Mehmet-Emre-Dogan/EE464_2022-2023_TermProject/README.md

# EE464_2022-2023_TermProject
 Hardware Project for EE464

 https://github.com/odtu/ee464

# Magnetic Design Report
 https://github.com/Mehmet-Emre-Dogan/EE464_2023_HW2_Team08
 
 # Experiments
 
 ## 0th Experiment
 https://youtu.be/MJ3PV6YCNdQ
