Mehmet-Emre-Dogan/EE464_2022-2023_TermProject/presentation/presentation.pptx

## EE464 Static Power Conversion II Hardware Project Feedback Presentation

Mehmet Emre Doğan
Metehan Küçükler

## Outline

- Problem Definition
- Topology Selection
- Plan B
- Targeted Bonuses
- Experimental Results
- Simulation Result
- Component Selection
- Conclusion

## Problem Definition

→ Isolated DC-DC converter with specs:
- Minimum Input Voltage: 12 V
- Maximum Input Voltage: 18 V
- Output Voltage: 48 V
- Output Power: 48 W
- Output Voltage P2P Ripple: 3%
- Line Regulation: 3%
- Load Regulation: 3%

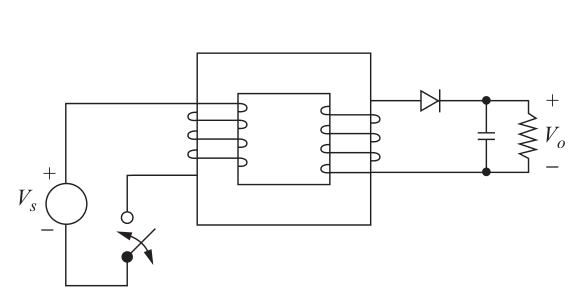
[picture p27: figure]

## Topology Selection

- Available topologies:
- Flyback converter
- Forward converter
- Push-Pull converter

## Topology Selection

- Flyback topology is chosen
- Requires less turns ratio compared to forward converter
- Requires more basic transformer compared to push-pull converter
- Require less number of components
- More importantly, we have found controller IC UCC2813DTR-1*
- The IC has a base design on TI Webench

* https://www.ti.com/product/UCC2813%2D1

## Topology Selection

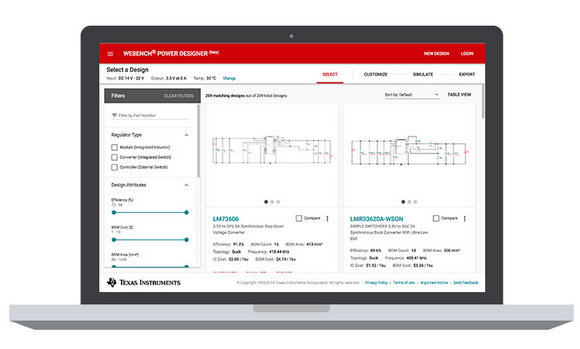
[picture p28: figure]

- TI Webench
- Online tool to make power electronics circuit designs

https://webench.ti.com/power-designer/switching-regulator

## Slide 7

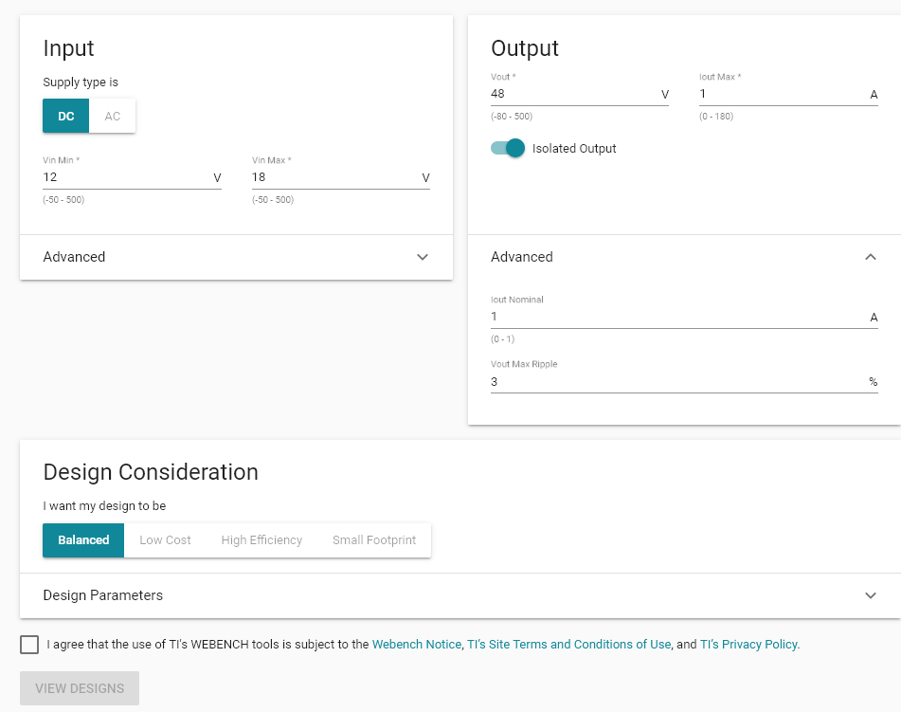
[picture p29: figure]

## In Case Analog IC Cause Unsolvable Problems

- Arduino (ESP8266) based solution
- ROE series isolated converters
- I2C ADC ADS1115
- I2C Isolator ISO1642DWR
- ESP in primary
- Isolated ADC in secondary

## Targeted Bonuses

- Single Supply
- Current Mode Control
- Analog Controller IC
- PCB
- Industrial Design
- Efficiency: Depends on other teams

## Experimental Results

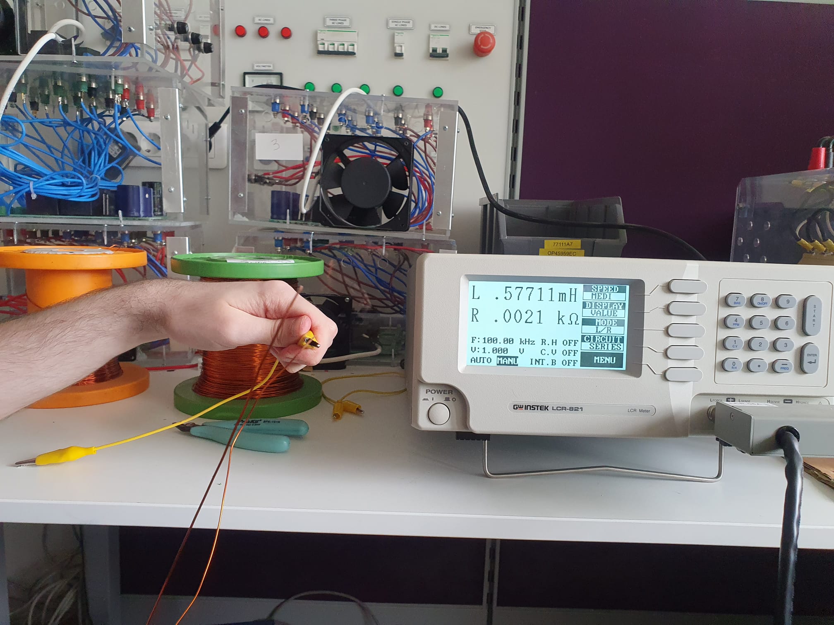
[picture p30: figure]
makine, metin, iç mekan, elektronik donanım içeren bir resim Açıklama otomatik olarak oluşturuldu

## Experimental Results

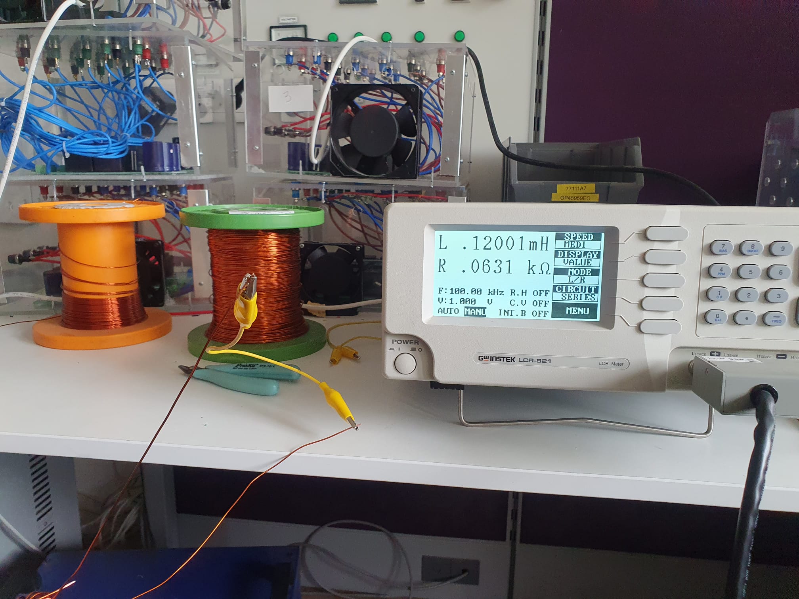
[picture p31: figure]
metin, makine, iç mekan, tıbbi cihazlar içeren bir resim Açıklama otomatik olarak oluşturuldu

## Experimental Results

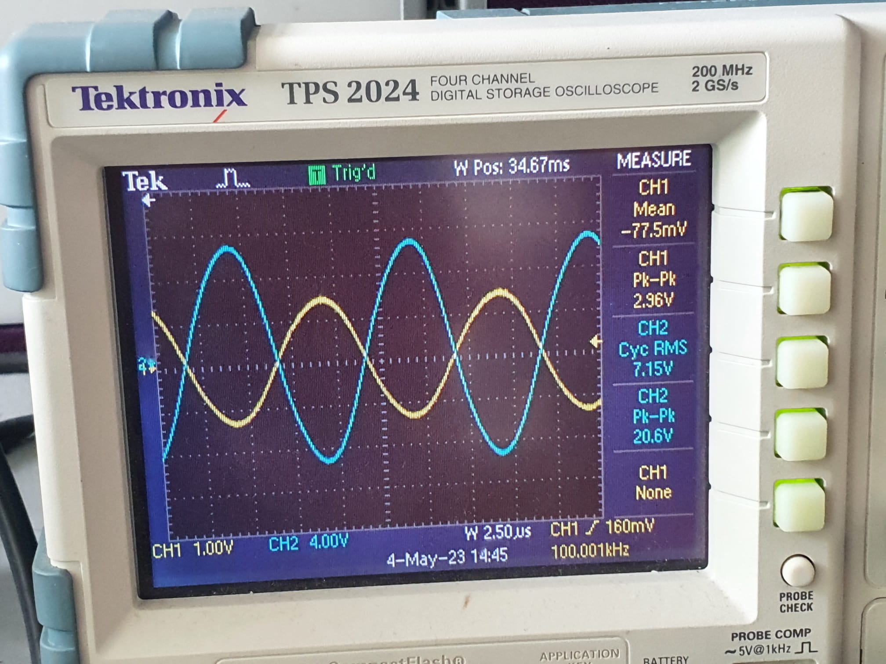
[picture p32: figure]
metin, elektronik donanım, multimedya, ekran içeren bir resim Açıklama otomatik olarak oluşturuldu

## Experimental Results

## Simulation Results

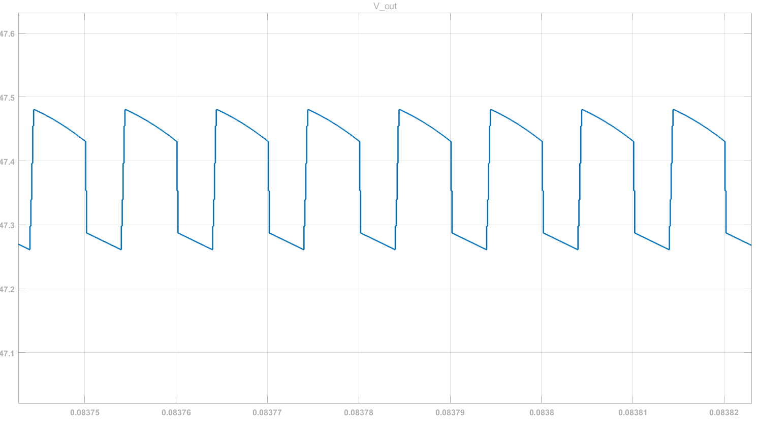
[picture p33: figure]
metin, yazı tipi, ekran görüntüsü, diyagram içeren bir resim Açıklama otomatik olarak oluşturuldu

## Simulation Results

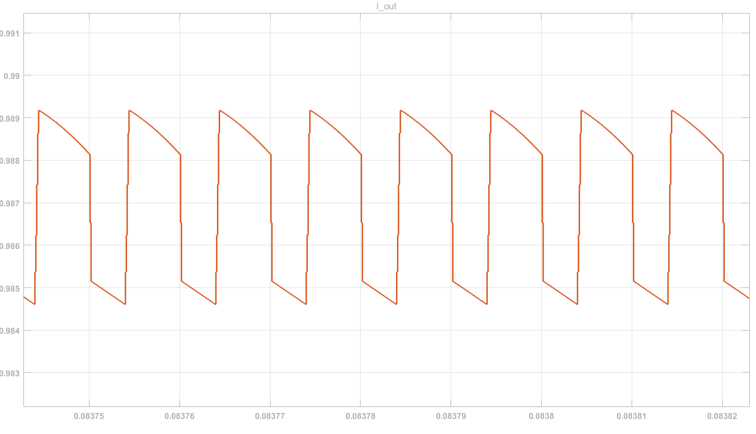
[picture p34: figure]
çizgi, öykü gelişim çizgisi; kumpas; grafiğini çıkarma, diyagram, paralel içeren bir resim Açıklama otomatik olarak oluşturuldu

## Simulation Results

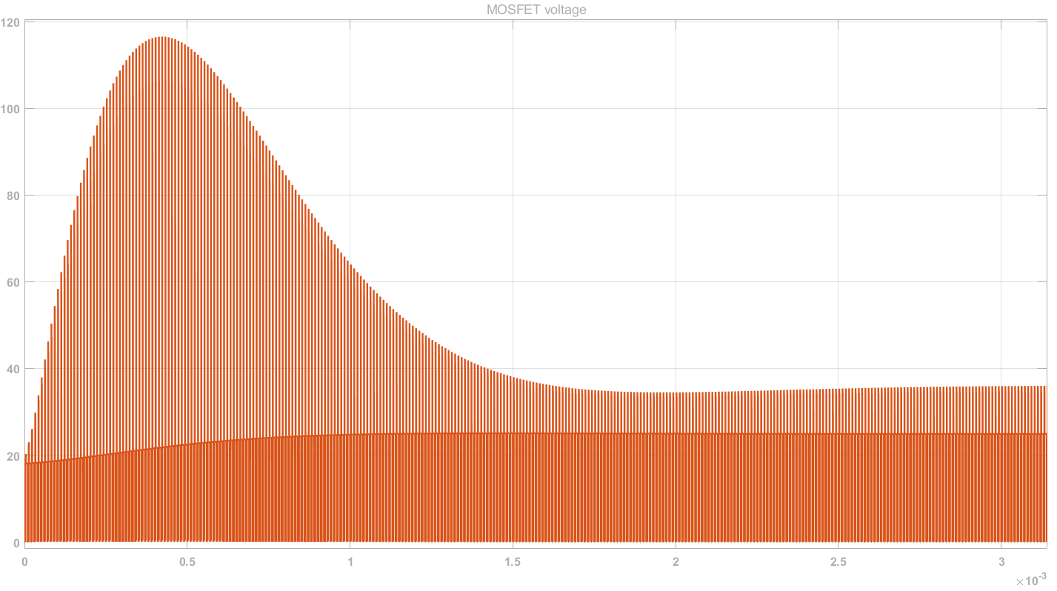
[picture p35: figure]

## Simulation Results

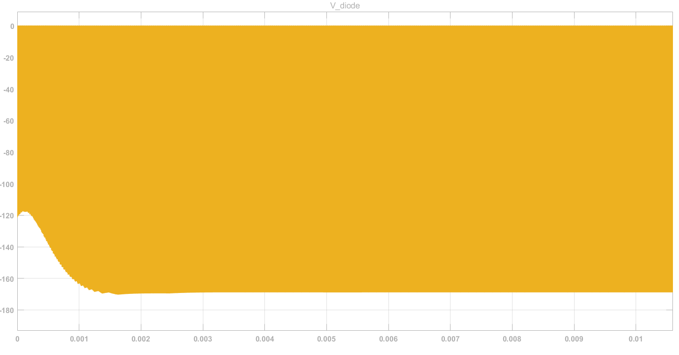
[picture p36: figure]

## Simulation Results

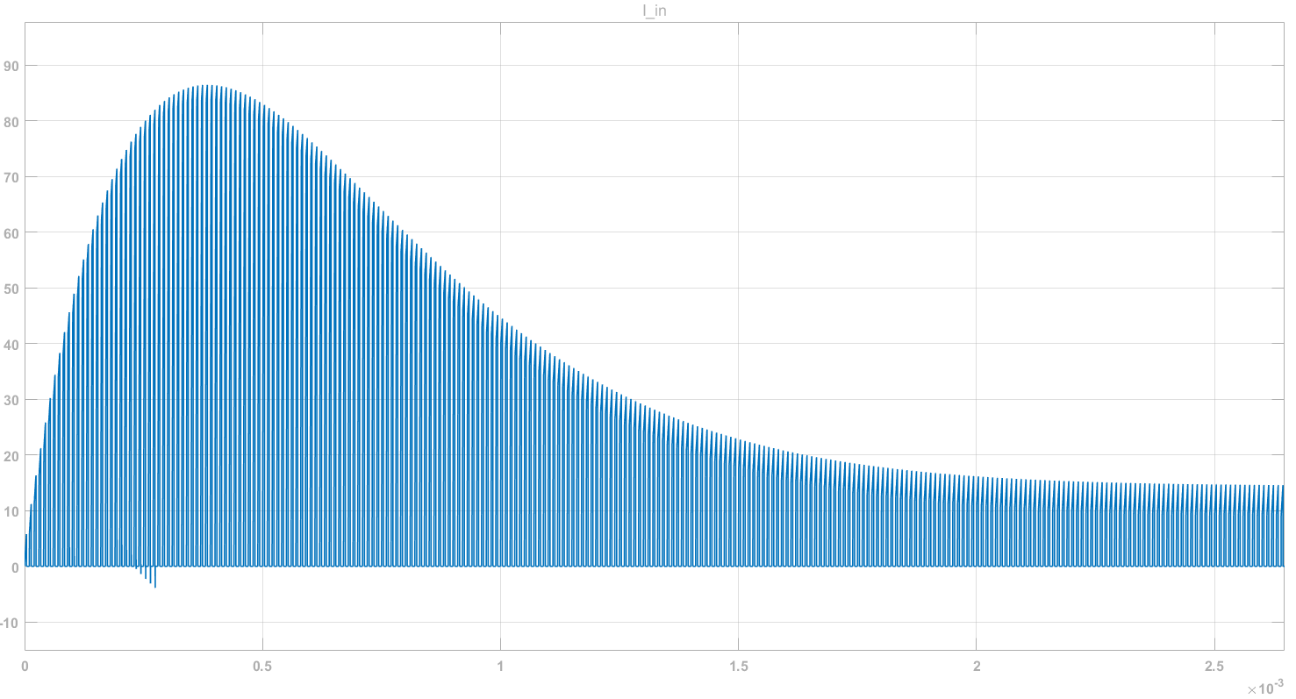
[picture p37: figure]
çizgi, öykü gelişim çizgisi; kumpas; grafiğini çıkarma, ekran görüntüsü, eğim, bayır içeren bir resim Açıklama otomatik olarak oluşturuldu

## Component Selection

MOSFET -> CSD19502Q5B
Vds = 80V, Ids = 100A, Rds = 3.8mΩ

DIODE -> SE10DTLJ
Vrrm = 600V, If = 10 A, Vf = 0.83 V

Output Capacitor
C = 47μF, V_rated = 100 V, ESR = 330mΩ

## Conclusion

- First implementations on perforated prototype board
- Continue improving transformer design to reduce leakage inductance
- Test and calibrate feedback and compensation of the controller IC
