Mehmet-Emre-Dogan/EE464_2022-2023_TermProject/case.stl

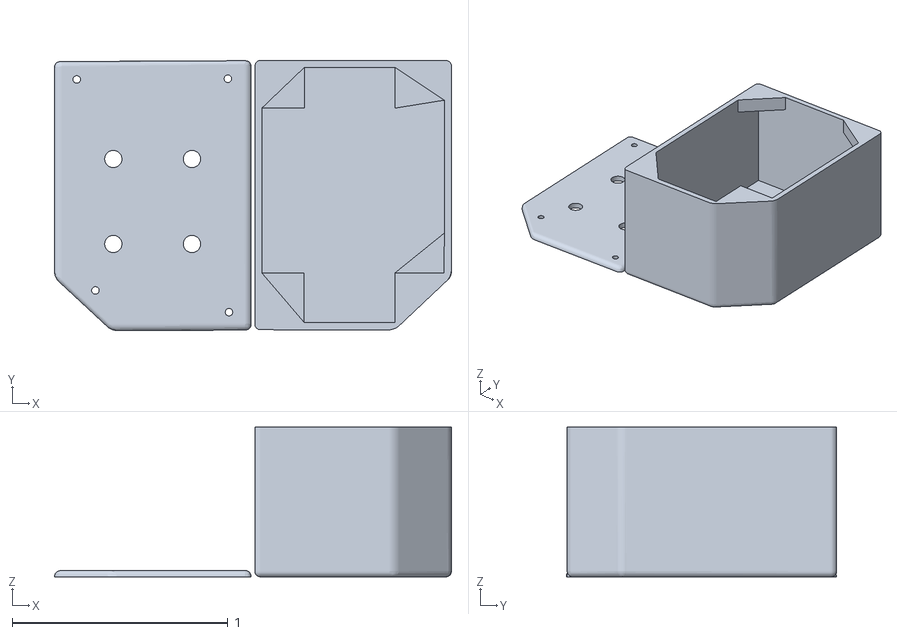
[picture p63: CAD file, 2023-06-14]
case.stl
1.84 x 1.25 x 0.694
