Mehmet-Emre-Dogan/EE464_2022-2023_TermProject/transformer v1.step

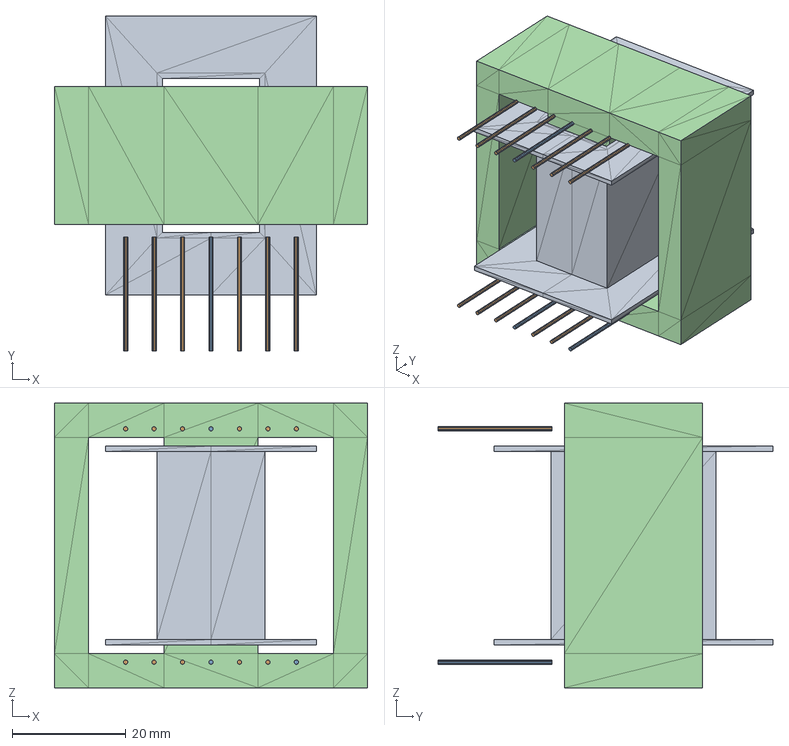
[picture p64: CAD file, 2023-06-14]
transformer v1.step
55.0 x 58.8 x 50.0 mm
