Mehmet-Emre-Dogan/EE464_2022-2023_TermProject/(list of files, cad)

Other CAD files:
transformer.step
transformer v1.stl
transformer.stl
