Mehmet-Emre-Dogan/EE464_2022-2023_TermProject/experiments/transformer_winding/readme.md

# First Transformer Experiment
The wounded toroidal transformer is tested with 100 kHz sinusoidal waveform with a signal generator.

## Transformer
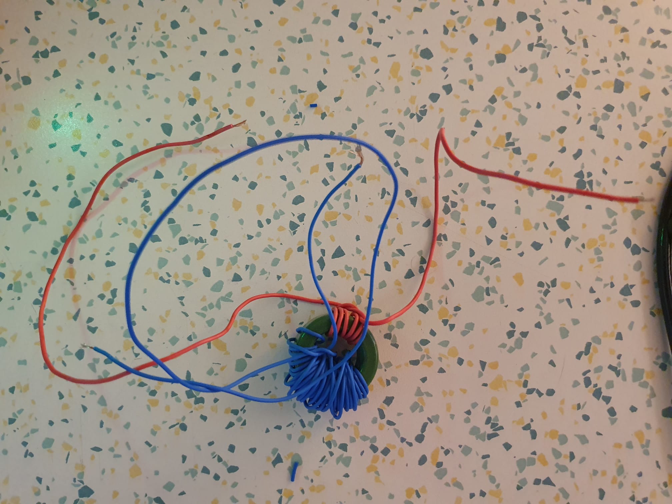
[picture p65: experiments/transformer_winding/pic.jpeg]
xformer


## Primary Inductance
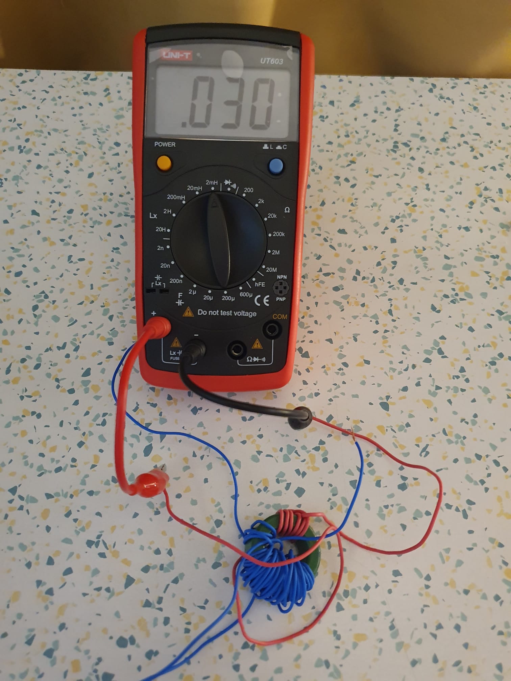
[picture p66: experiments/transformer_winding/pri.jpeg]
pri


## Secondary Inductance
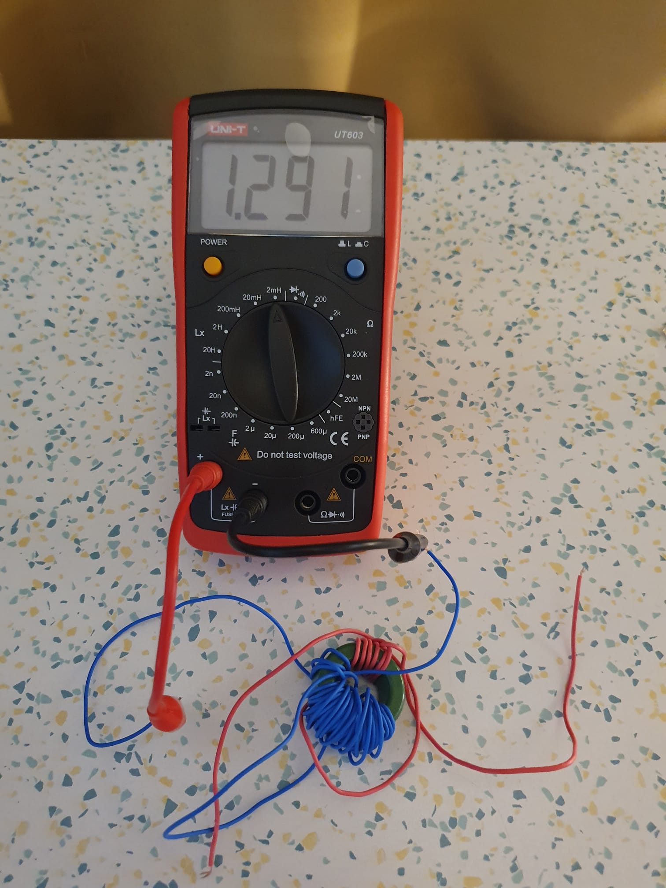
[picture p67: experiments/transformer_winding/sec.jpeg]
sec


## Scope Waveforms
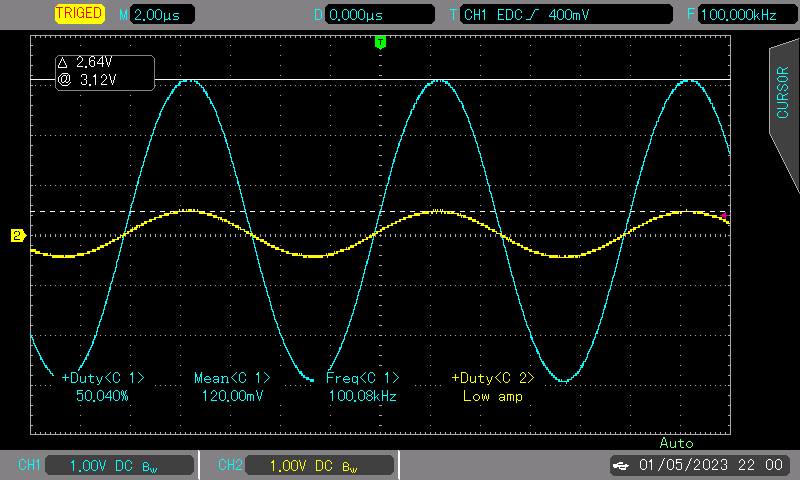
[picture p68: experiments/transformer_winding/dso.BMP]
scope

- Yellow: Primary
- Blue: Secondary
