Mehmet-Emre-Dogan/EE464_2022-2023_TermProject/preliminaryDesigns/experiments/Ne555FixedFreqFixedDutySquare/CH2.CSV

Source | CH2 | us | mV
 |  | -3.50000E+02 | 1.22E+04
 |  | -3.49900E+02 | 1.22E+04
 |  | -3.49800E+02 | 1.24E+04
 |  | -3.49700E+02 | 1.24E+04
 |  | -3.49600E+02 | 1.22E+04
 |  | -3.49500E+02 | 1.22E+04
 |  | -3.49400E+02 | 1.24E+04
 |  | -3.49300E+02 | 1.24E+04
 |  | -3.49200E+02 | 1.22E+04
 |  | -3.49100E+02 | 1.22E+04
 |  | -3.49000E+02 | 1.24E+04
 |  | -3.48900E+02 | 1.24E+04
 |  | -3.48800E+02 | 1.22E+04
 |  | -3.48700E+02 | 1.22E+04
 |  | -3.48600E+02 | 1.24E+04
 |  | -3.48500E+02 | 1.24E+04
 |  | -3.48400E+02 | 1.22E+04
 |  | -3.48300E+02 | 1.22E+04
 |  | -3.48200E+02 | 1.24E+04
 |  | -3.48100E+02 | 1.24E+04
 |  | -3.48000E+02 | 1.22E+04
 |  | -3.47900E+02 | 1.22E+04
 |  | -3.47800E+02 | 1.24E+04
 |  | -3.47700E+02 | 1.24E+04
 |  | -3.47600E+02 | 1.22E+04
 |  | -3.47500E+02 | 1.22E+04
 |  | -3.47400E+02 | 1.26E+04
 |  | -3.47300E+02 | 1.24E+04
 |  | -3.47200E+02 | 1.22E+04
 |  | -3.47100E+02 | 1.22E+04
 |  | -3.47000E+02 | 1.24E+04
 |  | -3.46900E+02 | 1.24E+04
 |  | -3.46800E+02 | 1.22E+04
 |  | -3.46700E+02 | 1.22E+04
 |  | -3.46600E+02 | 1.24E+04
 |  | -3.46500E+02 | 1.24E+04
 |  | -3.46400E+02 | 1.22E+04
 |  | -3.46300E+02 | 1.24E+04
 |  | -3.46200E+02 | 1.24E+04
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
