Mehmet-Emre-Dogan/EE464_2022-2023_TermProject/preliminaryDesigns/experiments/Ne555FixedFreqFixedDutySquare/DSOBMP01.BMP

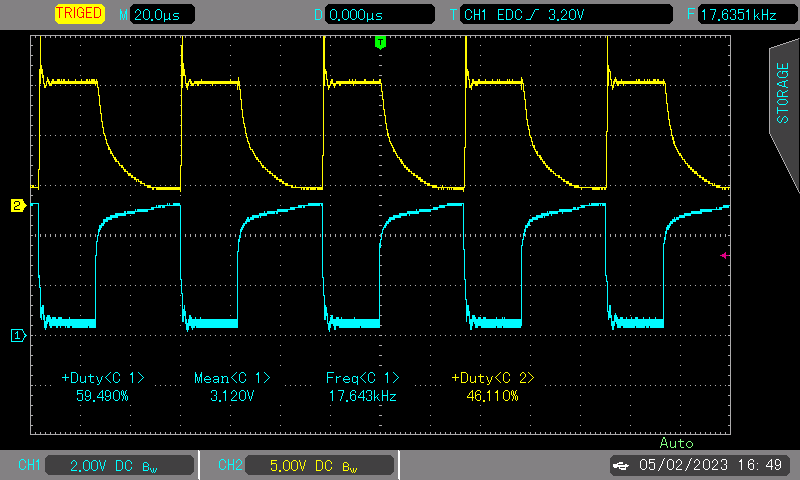
preliminaryDesigns/experiments/Ne555FixedFreqFixedDutySquare/DSOBMP01.BMP
