Mehmet-Emre-Dogan/EE464_2022-2023_TermProject/preliminaryDesigns/experiments/Ne555FixedFreqFixedDutySquare/WhatsApp Image 2023-02-05 at 17.32.45.jpeg

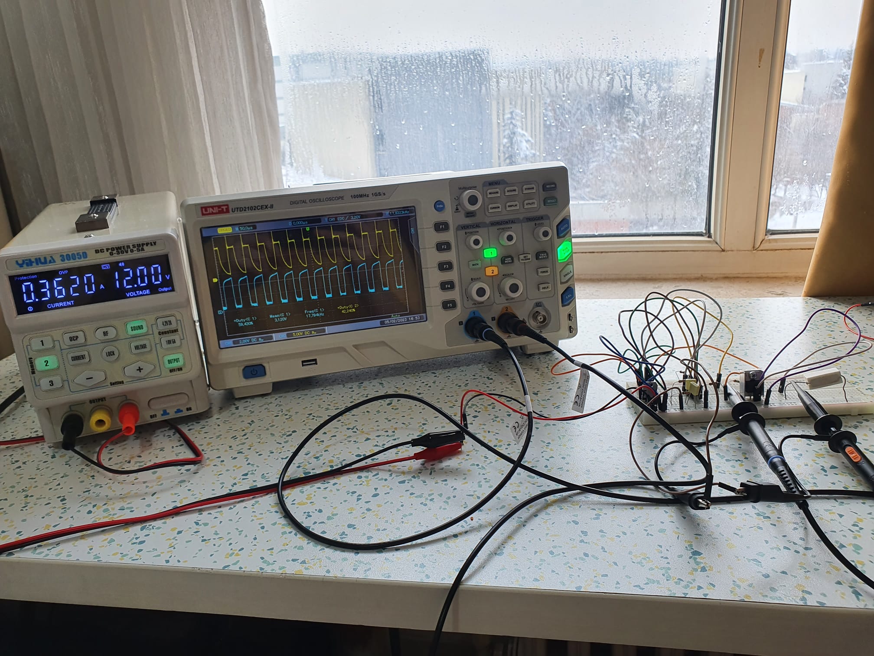
preliminaryDesigns/experiments/Ne555FixedFreqFixedDutySquare/WhatsApp Image 2023-02-05 at 17.32.45.jpeg
