Mehmet-Emre-Dogan/EE464_2022-2023_TermProject/preliminaryDesigns/experiments/squareInput_isolDCOutput/handdrawn_sch.jpeg

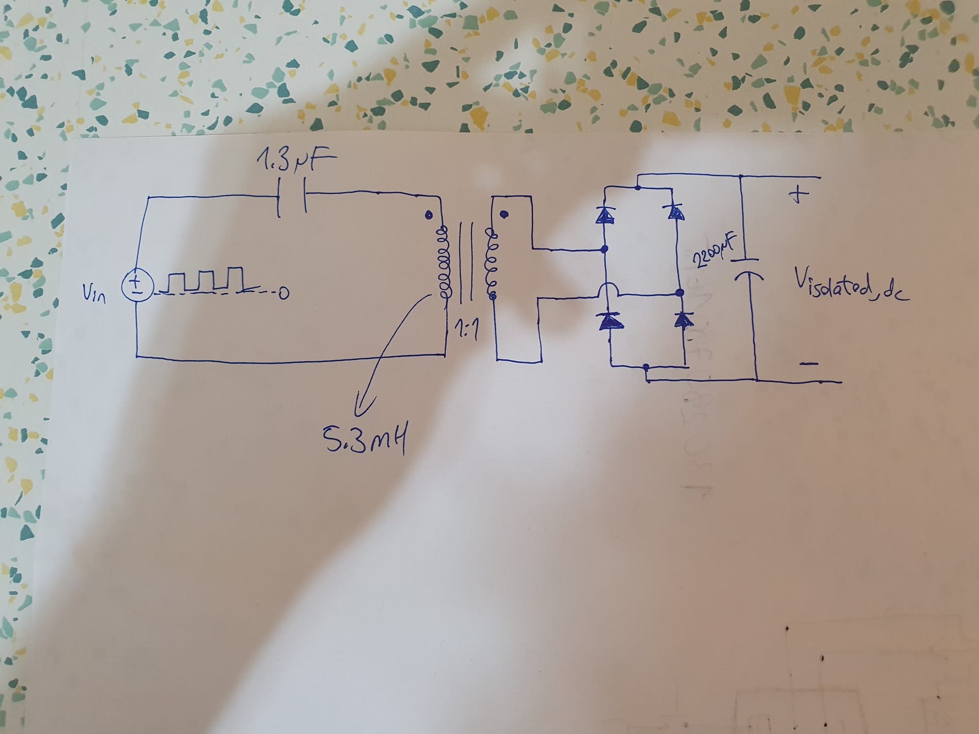
preliminaryDesigns/experiments/squareInput_isolDCOutput/handdrawn_sch.jpeg
