Mehmet-Emre-Dogan/EE464_2022-2023_TermProject/spice-tests/Draft1.asc

C1: cap; 47µ; Rser=330
C2: cap; 47µ; Rser=330
C9: cap; 47µ; Rser=330
C12: cap; 10n; Rser=280m
C13: cap; 1n
C21: cap; 68µ; Rser=1.56
C22: cap; 22p
C23: cap; 56p
Ccs: cap; 470p
Cin2: cap; 4.7µ; Rser=3m
Cin: cap; 4.7µ; Rser=3m
Cref: cap; 100n; Rser=280m
Csnub: cap; 2.2µ; Rser=1m
Ct: cap; 1n; Rser=25m
Cvcc: cap; 4.7µ; Rser=3
D1: schottky; RBS3MM40A
D2: schottky; RBLQ20BGE10
D3: diode; VS-E5TH1506
D4: zener; MMBZ24VALY
D5: schottky; RB088LAM-60
L1: ind2; 2.814µ
L2: ind2; 134.75µ
L3: ind2; 7.5µ
M1: nmos; AONS62814T
Q1: npn; BC846B
Qsc: npn; 2N2222
R2: res; 10
R11: res; 10k
R12: res; 7.68k
R13: res; 4.99k
R17: res; 1000k
R21: res; 10k
Rbias: res; 13.7k
Rcs: res; 1k
Rdrv: res; 12.1
Rfbb: res; 3.01k
Rfbt: res; 54.9K
Rled: res; 16.2k
Rload: res; 48
Rsc: res; 4.32k
Rsns: res; 33.33m
Rsnub1: res; 118.45
Rsnub2: res; 118.45
Rstartup1: res; 3.3k
Rstartup2: res; 3.3k
Rt: res; 15k
Rz: res; 20k
U1: UCCx813-1
U2: TLP388
U3: TL431
V1: voltage; 12
Named nets: 0, COM
.tran 0 1 0 10n startup
K1 L1 L2 1
K2 L1 L3 1
K3 L2 L3 1
