Mehmet-Emre-Dogan/EE464_2022-2023_TermProject/spice-tests/Draft2.asc

C1: cap; 68µ
C2: cap; 56p
C3: cap; 22p
D1: zener; MMBZ24VALY
D3: schottky; RB095T-60NZ
Q1: npn; BC846B
R1: res; 48
R2: res; 54.9k
R3: res; 3.01k
R4: res; 22k
R5: res; 15k
R6: res; 56k
R7: res; 3.3k
R8: res; 15k
R9: res; 10k
R10: res; 1000k
R11: res; 5k
R12: res; 8.2k
R13: res; 1000k
U1: TL431
U2: TL431
U3: PC817C
V1: voltage; 47
V2: voltage; 45
V3: voltage; 5
Named nets: 0
.tran 1
