Mehmet-Emre-Dogan/EE464_2022-2023_TermProject/pcb-design2/pcb-design.kicad_pcb

## KiCad design pcb-design2/pcb-design.kicad_pcb (2023-06-20)

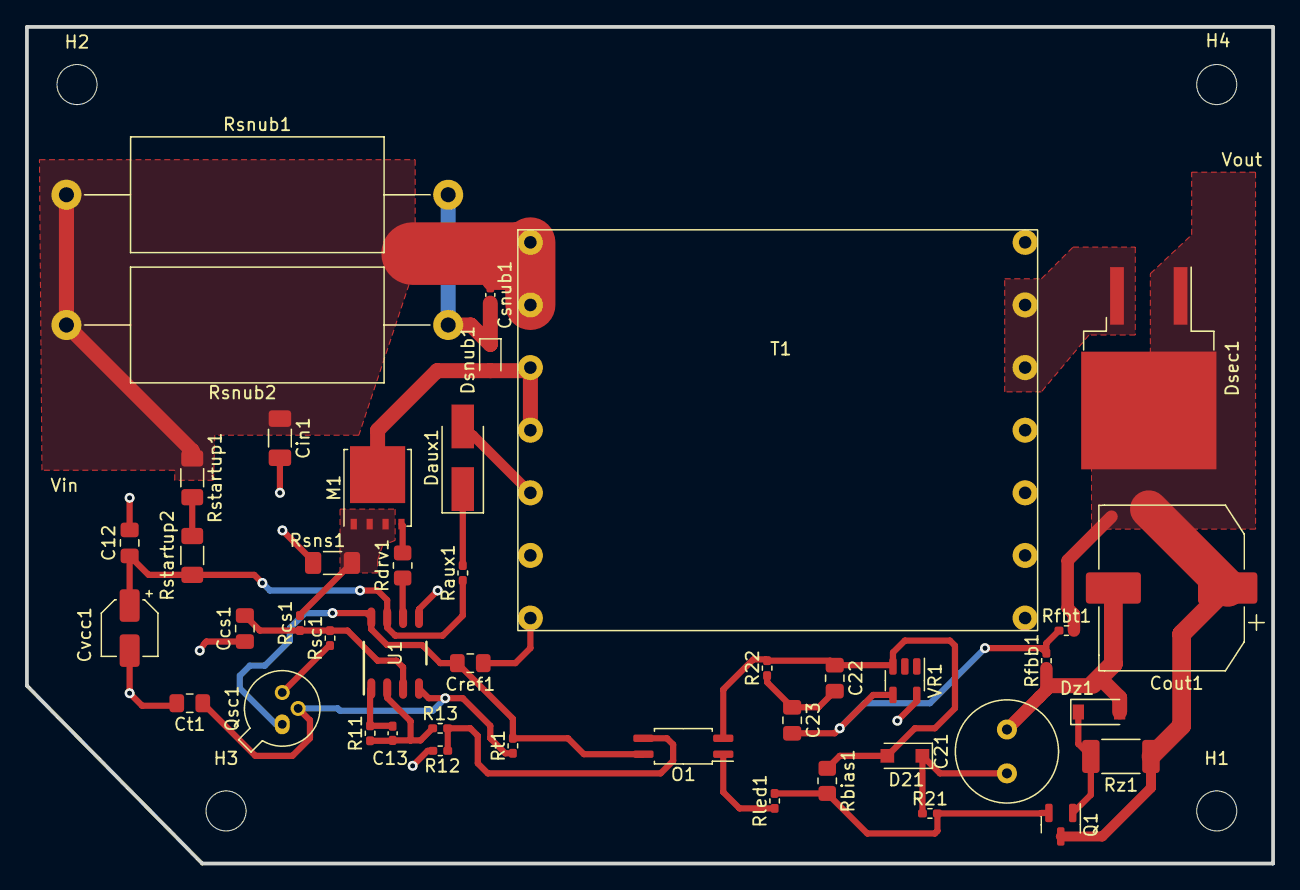
[picture p77: board pcb-design.kicad_pcb from above]

Board: 2 copper layers, 99.5 x 66.8 mm, 48 parts (0 on the bottom side), 28 nets.

Parts:
C12: 100 nF; C_0805_2012Metric_Pad1.18x1.45mm_HandSolder
C13: 1 nF; C_0402_1005Metric_Pad0.74x0.62mm_HandSolder
C21: 68 uF; C_Radial_D8.0mm_H11.5mm_P3.50mm
C22: 22 pF; C_0805_2012Metric_Pad1.18x1.45mm_HandSolder
C23: 56 pF; C_0805_2012Metric_Pad1.18x1.45mm_HandSolder
Ccs1: 470 pF; C_0805_2012Metric_Pad1.18x1.45mm_HandSolder
Cin1: 4.7 uF; C_1206_3216Metric_Pad1.33x1.80mm_HandSolder
Cout1: 47 uF; CP_Elec_12.5x13
Cref1: 100 nF; C_0805_2012Metric_Pad1.18x1.45mm_HandSolder
Csnub1: 2.2 uF; C_0402_1005Metric_Pad0.74x0.62mm_HandSolder
Ct1: 1 nF; C_0805_2012Metric_Pad1.18x1.45mm_HandSolder
Cvcc1: 4.7 uF; CP_Elec_4x5.3
D21: PMEG6010CEH; D_SOD-123F
Daux1: D_Schottky; D_SMA_Handsoldering
Dsec1: D; TO-263-2_TabPin1
Dsnub1: D_Schottky; D_SOD-323
Dz1: D_Zener; D_SOD-123
H1, H2, H3, H4: MountingHole; MountingHole_3.2mm_M3
M1: CSD19502Q5B; TDSON-8-1
O1: TCMT1107; SOP-4_4.4x2.6mm_P1.27mm
Q1: BC846; SOT-23
Qsc1: 2N2646; TO-18-3
R11, R21: 10 kR; R_0402_1005Metric_Pad0.72x0.64mm_HandSolder
R12: 7.68 kR; R_0402_1005Metric_Pad0.72x0.64mm_HandSolder
R13: 4.99 kR; R_0402_1005Metric_Pad0.72x0.64mm_HandSolder
R22: 1.15 MR; R_0402_1005Metric_Pad0.72x0.64mm_HandSolder
Raux1: 10 R; R_0402_1005Metric_Pad0.72x0.64mm_HandSolder
Rbias1: 13.7 kR; R_0805_2012Metric_Pad1.20x1.40mm_HandSolder
Rcs1: 1 kR; R_0402_1005Metric_Pad0.72x0.64mm_HandSolder
Rdrv1: 12.1 R; R_0805_2012Metric_Pad1.20x1.40mm_HandSolder
Rfbb1: 3.01 kR; R_0402_1005Metric_Pad0.72x0.64mm_HandSolder
Rfbt1: 54.9 kR; R_0402_1005Metric_Pad0.72x0.64mm_HandSolder
Rled1: 16.2 kR; R_0402_1005Metric_Pad0.72x0.64mm_HandSolder
Rsc1: 4.32 kR; R_0402_1005Metric_Pad0.72x0.64mm_HandSolder
Rsns1: 33.9637 mR; R_1206_3216Metric_Pad1.30x1.75mm_HandSolder
Rsnub1, Rsnub2: 118.452 R; R_Axial_DIN0922_L20.0mm_D9.0mm_P30.48mm_Horizontal
Rstartup1, Rstartup2: 3.83 kR; R_1206_3216Metric_Pad1.30x1.75mm_HandSolder
Rt1: 7.5 kR; R_0402_1005Metric_Pad0.72x0.64mm_HandSolder
Rz1: 20 kR; R_2010_5025Metric_Pad1.40x2.65mm_HandSolder
T1: Transformer_1P_2S; Custom_Transformer-P0.5-7
U1: UCC2813D-1; UCC2813-1D
VR1: TL431DBV; SOT-23-5

Connections:
GND: C21.2, Cout1.2, Dz1.2 (A), Rfbb1.1, T1.11, T1.12, VR1.5 (A)
GNDREF: C12.2, Ccs1.1, Cin1.2, Cref1.1, Ct1.2, Cvcc1.2, R12.1, Rsns1.1, T1.6 (SD), T1.7, U1.5 (GND)
unnamed: C12.1, Cvcc1.1, Raux1.1, Rstartup2.2, U1.7 (VCC)
unnamed: C13.1, R11.1, R13.1, U1.2 (FB)
unnamed: C13.2, R11.2, U1.1 (COMP)
unnamed: C21.1, D21.1 (K), R21.1
unnamed: C22.1, D21.2 (A), O1.2, R22.2, Rbias1.1, VR1.3 (K)
unnamed: C22.2, C23.1, R22.1
unnamed: C23.2, Rfbb1.2, Rfbt1.1, VR1.4 (REF)
unnamed: Ccs1.2, Rcs1.1, Rsc1.2, U1.3 (CS)
unnamed: Cref1.2, O1.4, Qsc1.1 (B2), Rt1.2, U1.8 (REF)
unnamed: Csnub1.2, Dsnub1.1 (K), Rsnub1.2, Rsnub2.2
unnamed: Ct1.1, Qsc1.2 (E), Rt1.1, U1.4 (RC)
unnamed: Daux1.1 (K), Raux1.2
unnamed: Daux1.2 (A), T1.5 (SC)
unnamed: Dsec1.2 (A), T1.9, T1.10
unnamed: Dsnub1.2 (A), M1.5 (D), T1.3 (SA), T1.4 (SB)
unnamed: Dz1.1 (K), Q1.1 (B), Rz1.2
unnamed: M1.1 (S), M1.2 (S), M1.3 (S), Rcs1.2, Rsns1.2
unnamed: M1.4 (G), Rdrv1.2
unnamed: O1.1, Rled1.1
unnamed: O1.3, R12.2, R13.2
unnamed: Q1.2 (E), R21.2, Rbias1.2, Rled1.2
unnamed: Qsc1.3 (B1), Rsc1.1
unnamed: Rdrv1.1, U1.6 (OUT)
unnamed: Rstartup1.2, Rstartup2.1
VDC: Cin1.1, Csnub1.1, Rsnub1.1, Rsnub2.1, Rstartup1.1, T1.1 (AA), T1.2 (AB)
Vout: Cout1.1, Dsec1.1 (K), Q1.3 (C), Rfbt1.2, Rz1.1
