Mehmet-Emre-Dogan/EE464_2022-2023_TermProject/(commit log)

2023-02-04 worked on fixed duty pwm generator
    used ne555
2023-02-05 redesign circuit with existing elements
2023-02-05 add experimental images for the 555 cct
    [CH1.CSV, CH2.CSV]
2023-04-02 move files
    [CH1.CSV, CH2.CSV]
2023-05-06 BOM list updated.
2023-05-27 add skin depth calculation and
    recalculate the effective AC resistances
2023-06-11 Schematic and footprints added for PCB design.
    [pcb-design.kicad_pcb, pcb-design.kicad_sch]
2023-06-11 Transformer footprint is added.
    [pcb-design.kicad_pcb, pcb-design.kicad_sch, transformer.step]
2023-06-14 Schematic is corrected. PCB Design is added.
    [pcb-design.kicad_pcb, pcb-design.kicad_sch]
2023-06-14 Case design is added and some minor fixes on PCB design.
    [case.stl, pcb-design.kicad_pcb, transformer v1.step, transformer v1.stl, transformer.stl]
2023-06-14 pcb improvements
    - zones changed solid fill from thermal relief
    - thicken lines
    - add more zones
    [pcb-design.kicad_pcb, pcb-design.kicad_sch]
2023-06-27 overview the magnetic design
2023-06-27 pcb design dection added
